Lanove/HotBerry/docs/pics/18.jpeg

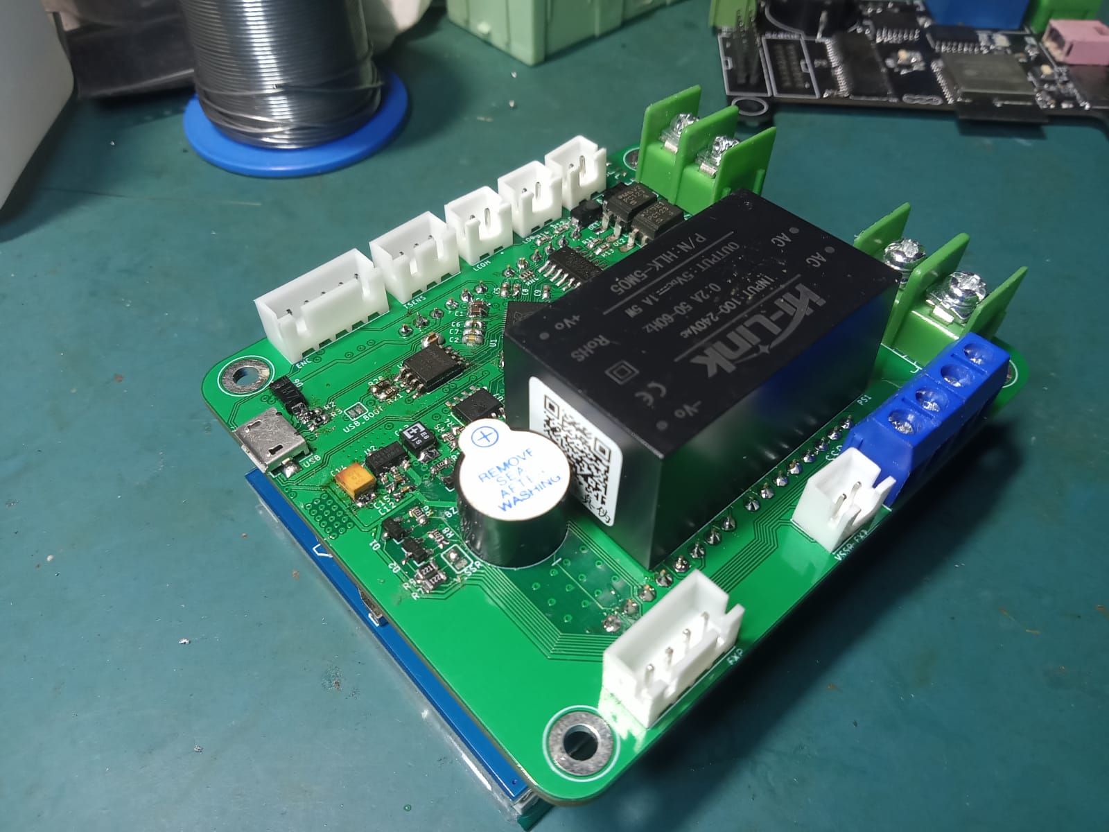
docs/pics/18.jpeg
