Lanove/HotBerry/docs/pics/13.jpeg

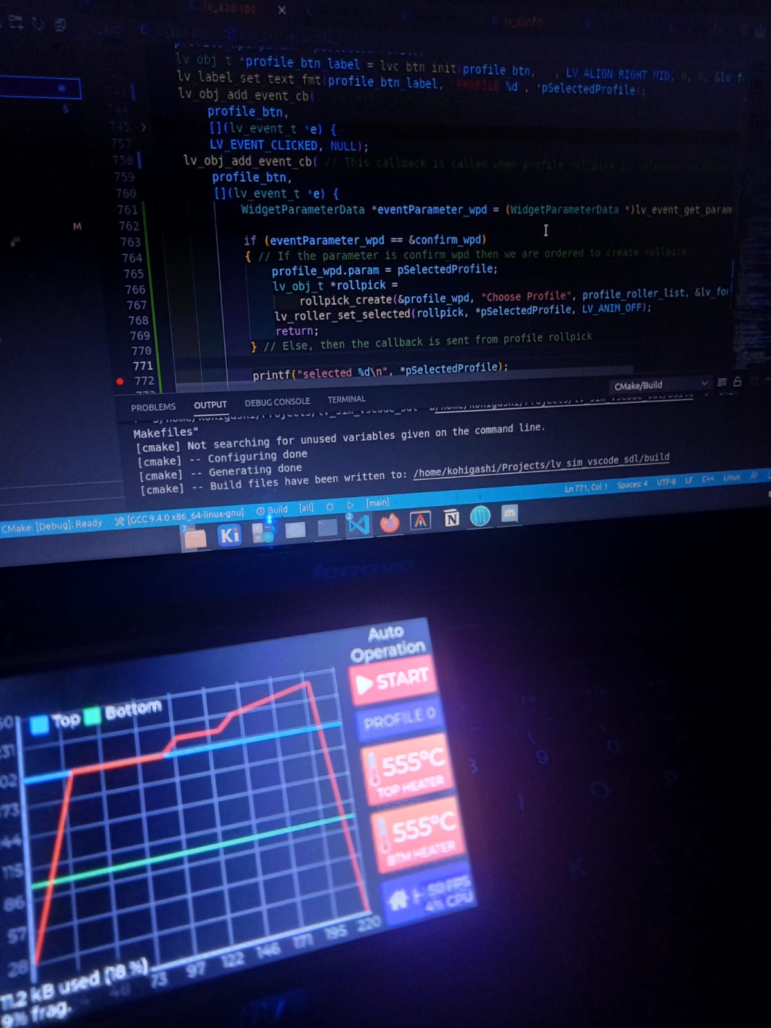
docs/pics/13.jpeg
