Lanove/HotBerry/docs/ILI9486 Data Format.pdf

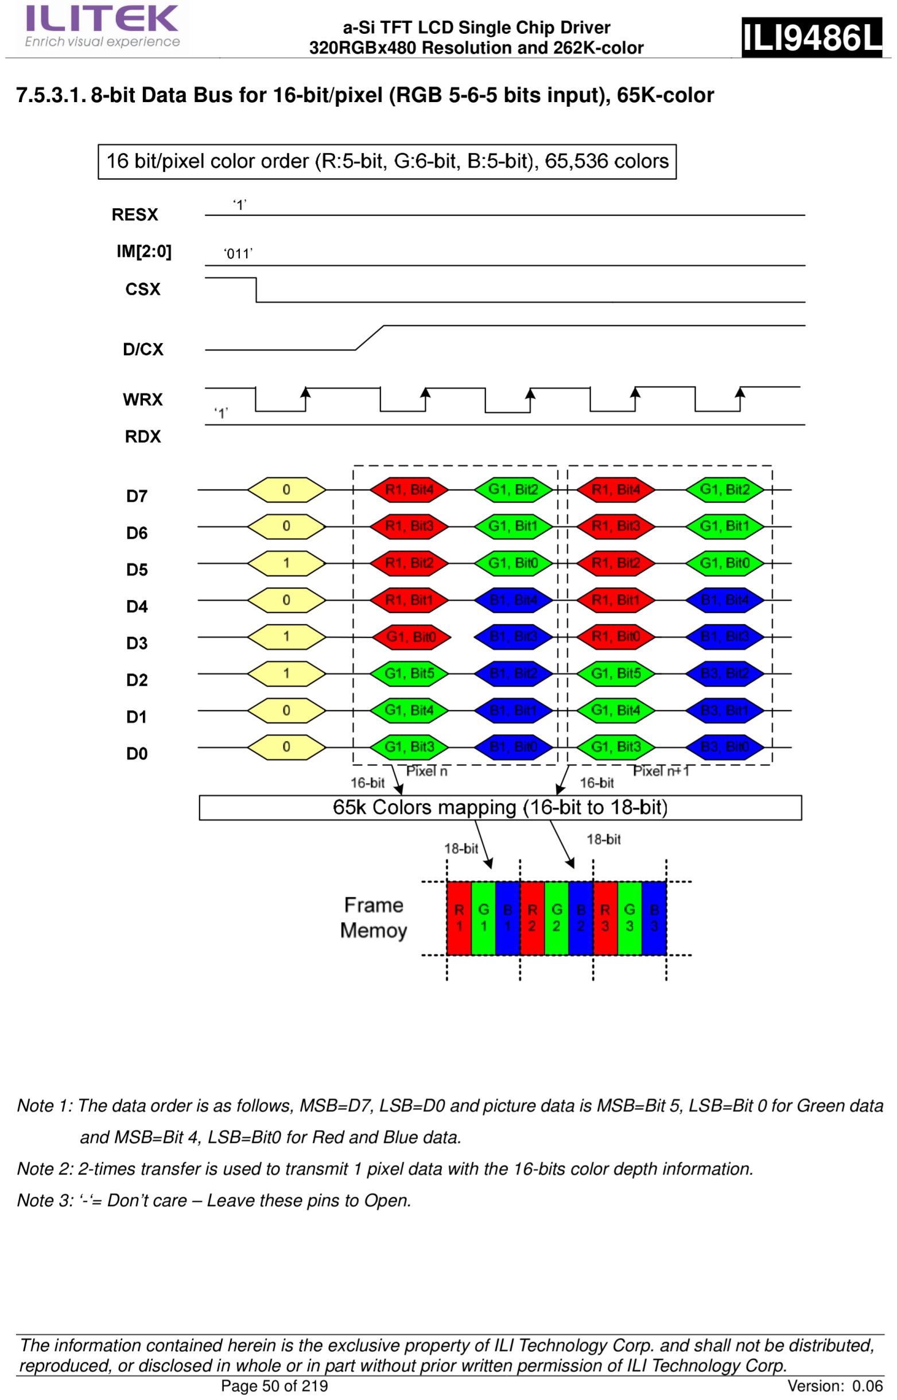
[picture p3: page 1]
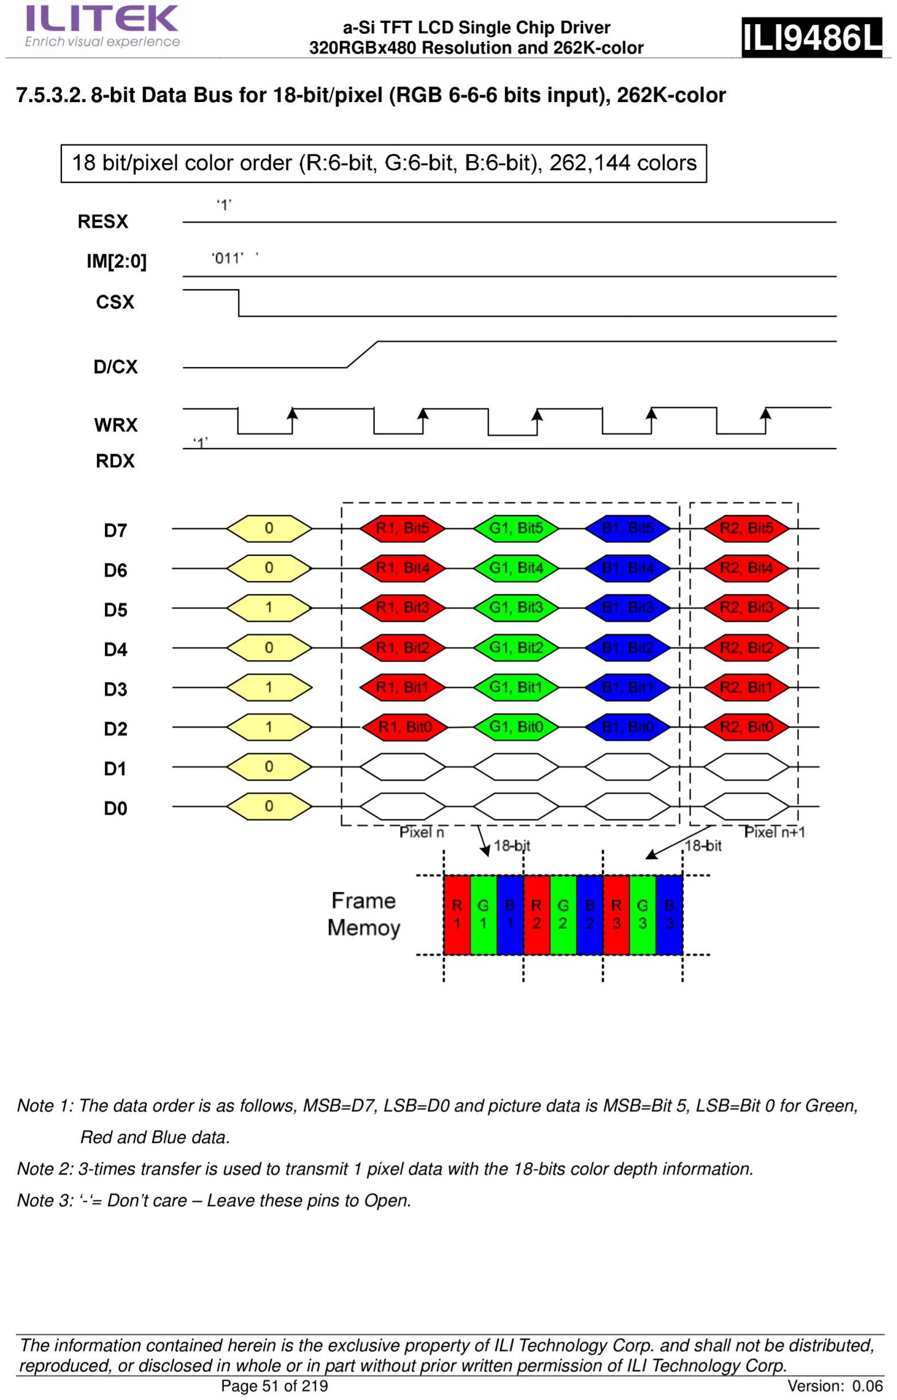
[picture p4: page 2]
