Lanove/HotBerry/docs/pics/4.jpeg

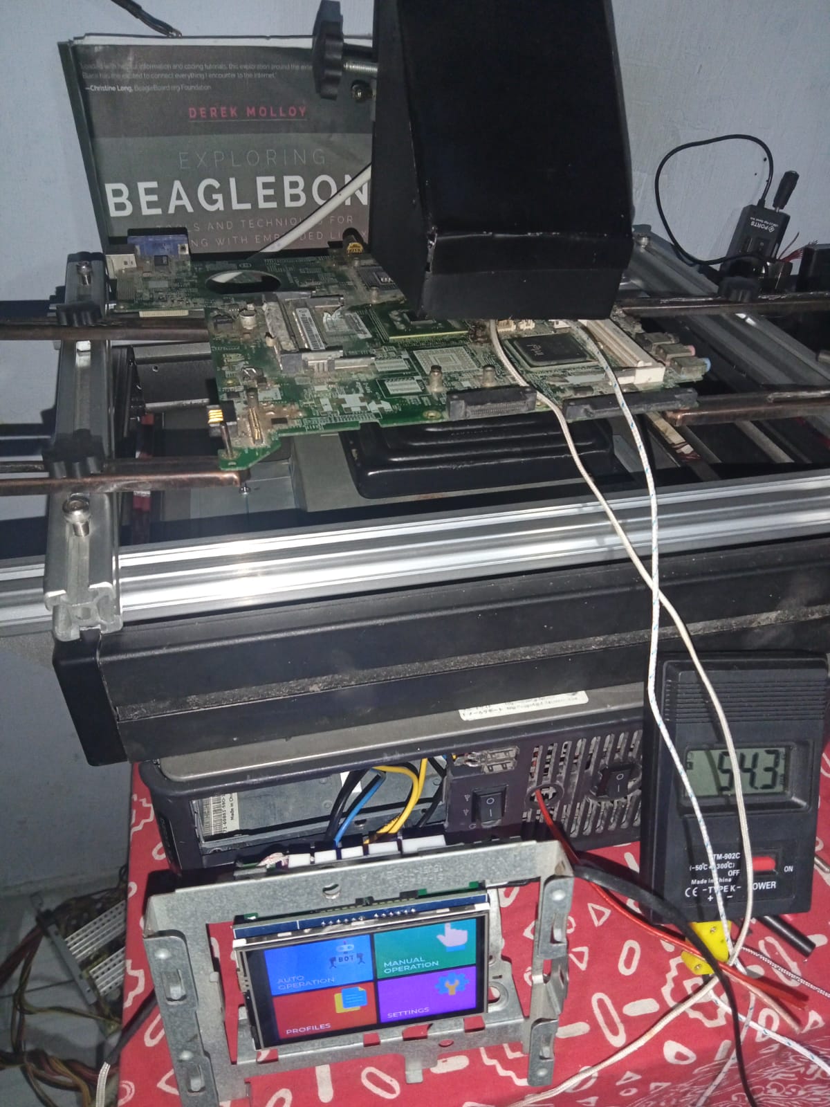
docs/pics/4.jpeg
