Lanove/HotBerry/docs/pics/5.jpeg

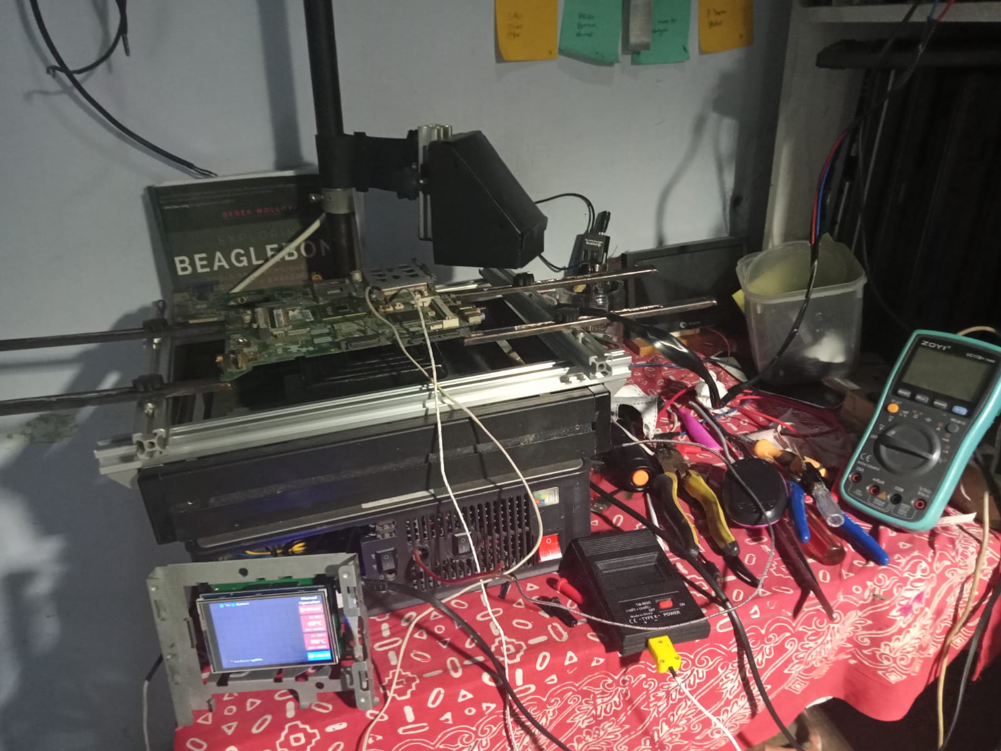
docs/pics/5.jpeg
