Lanove/HotBerry/docs/pics/6.jpeg

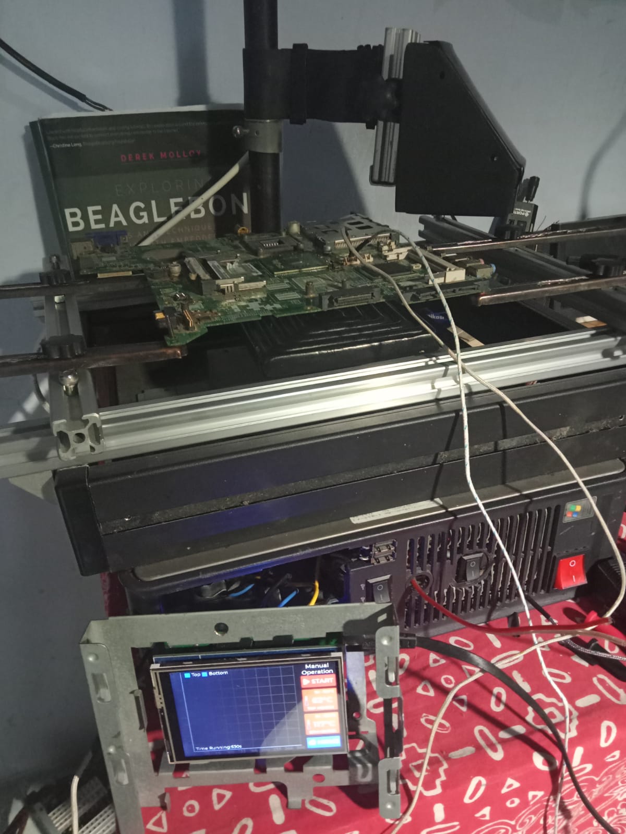
docs/pics/6.jpeg
