Lanove/HotBerry/docs/pics/7.jpeg

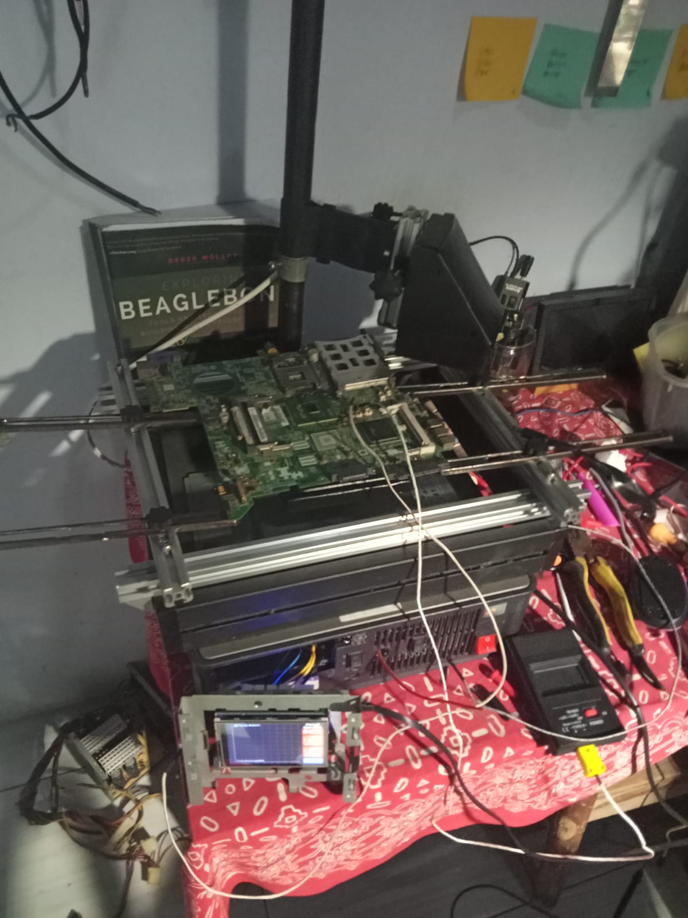
docs/pics/7.jpeg
