Lanove/HotBerry/docs/pics/8.jpeg

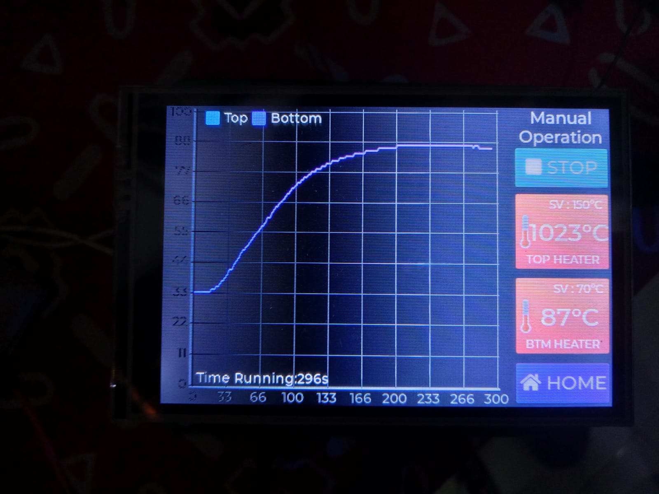
docs/pics/8.jpeg
