Lanove/HotBerry/docs/pics/9.jpeg

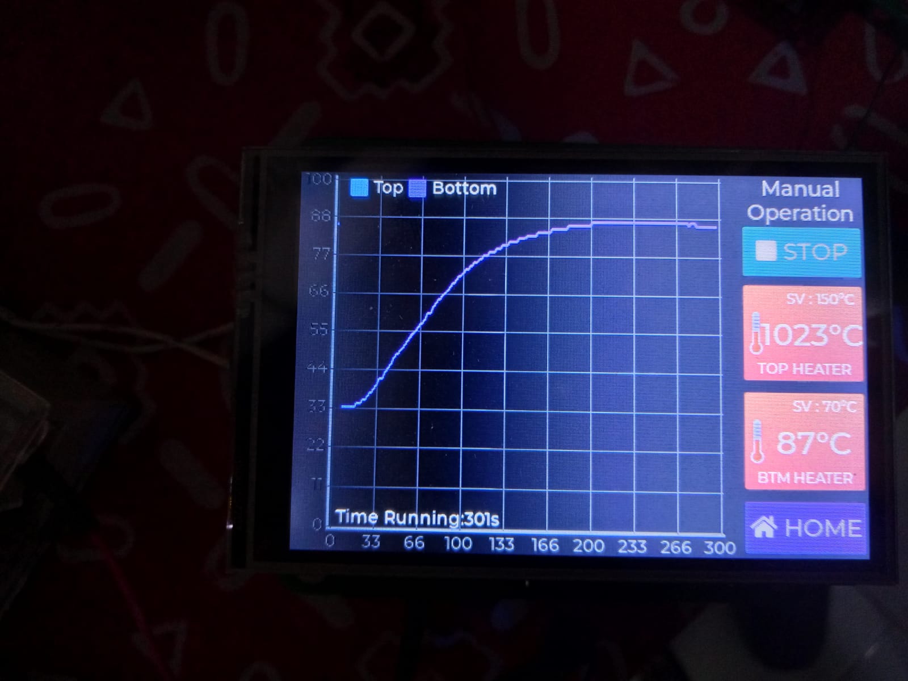
docs/pics/9.jpeg
