Lanove/HotBerry/docs/pics/10.jpeg

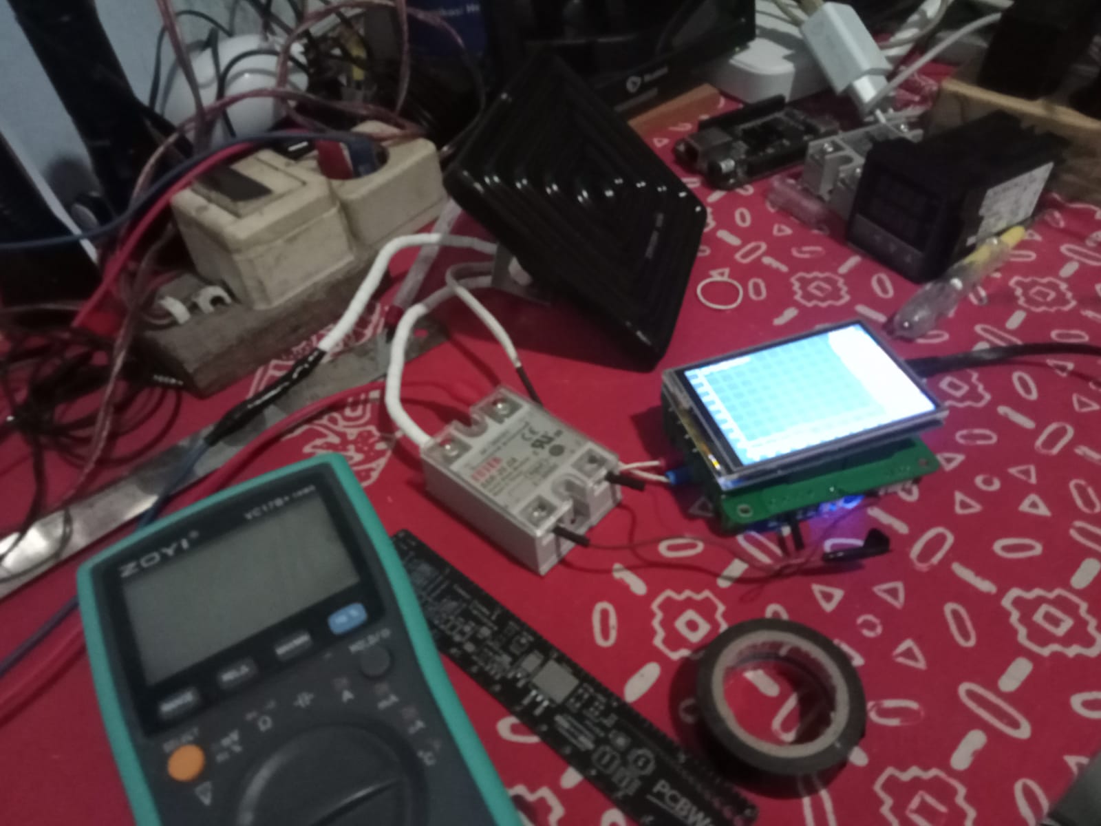
docs/pics/10.jpeg
