Lanove/HotBerry/docs/pics/11.jpeg

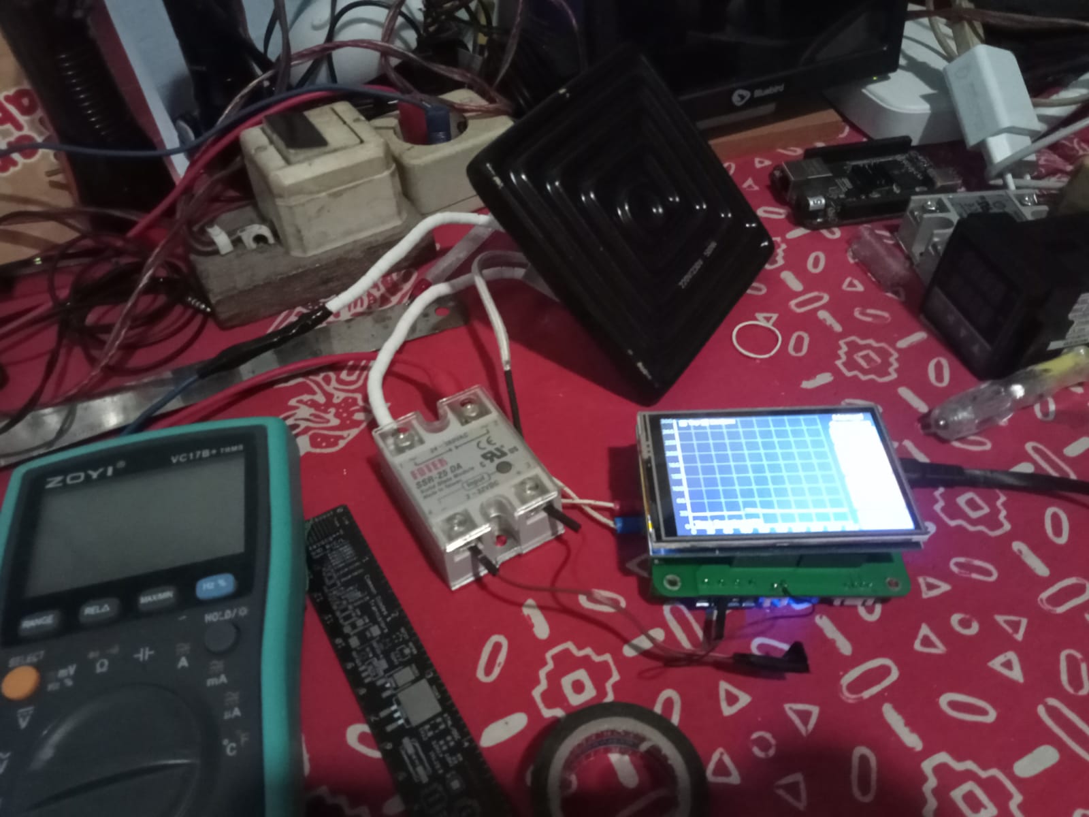
docs/pics/11.jpeg
