Lanove/HotBerry/docs/pics/12.jpeg

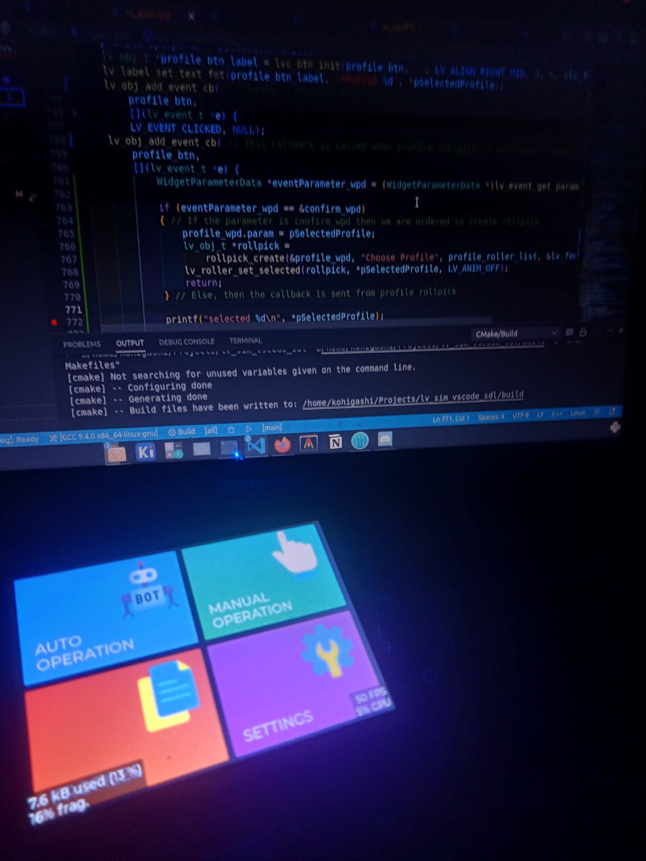
docs/pics/12.jpeg
