Lanove/HotBerry/docs/pics/14.jpeg

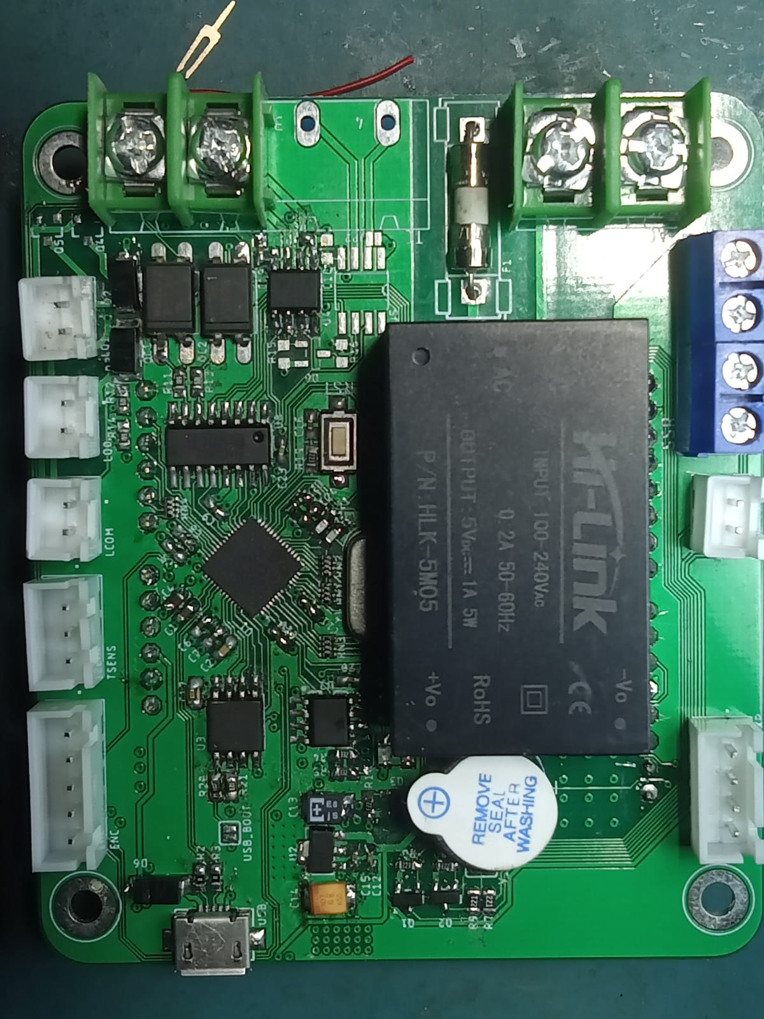
docs/pics/14.jpeg
