Lanove/HotBerry/docs/pics/15.jpeg

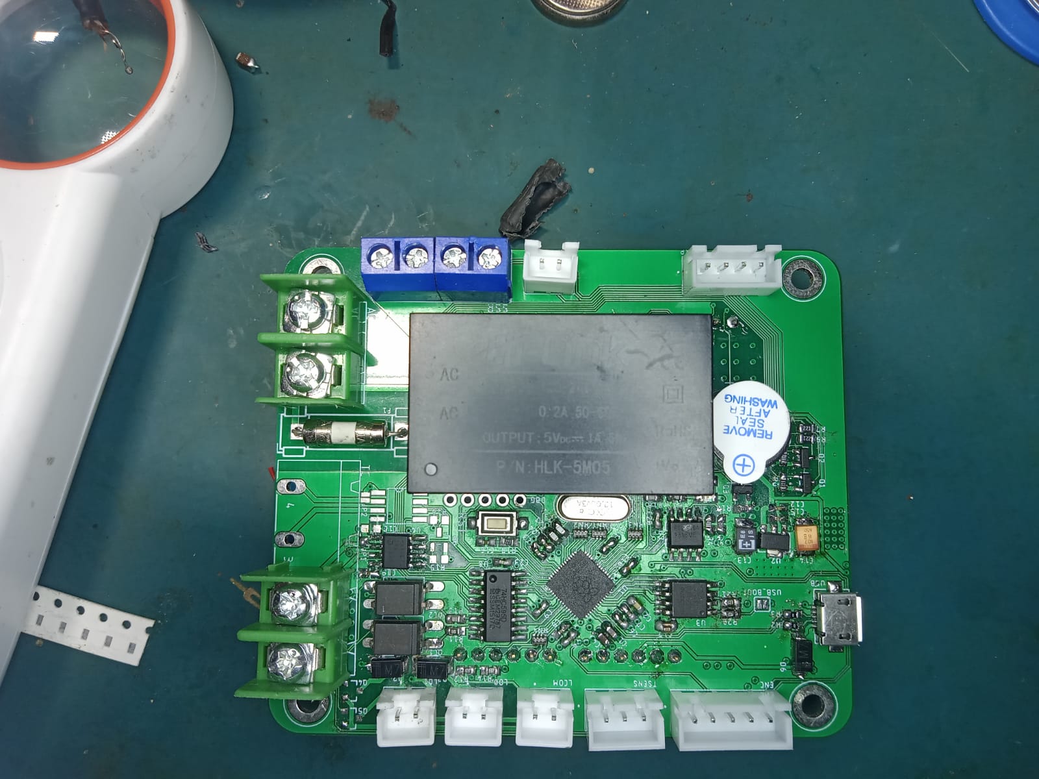
docs/pics/15.jpeg
