Lanove/HotBerry/docs/pics/16.jpeg

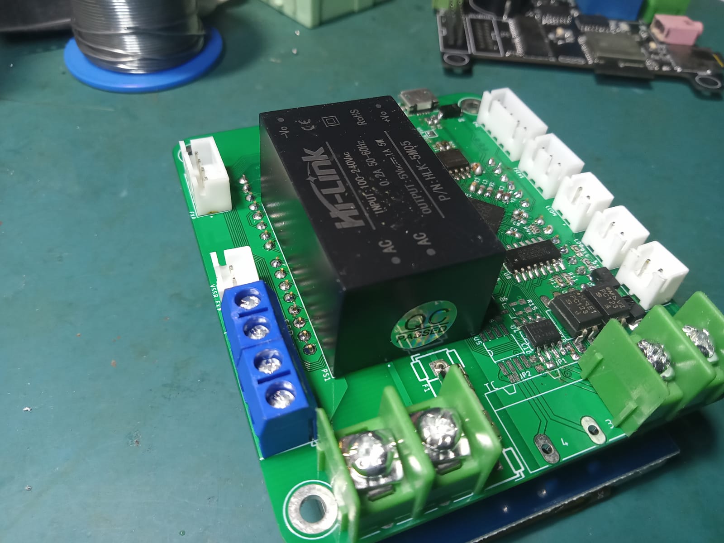
docs/pics/16.jpeg
