Lanove/HotBerry/docs/pics/19.jpeg

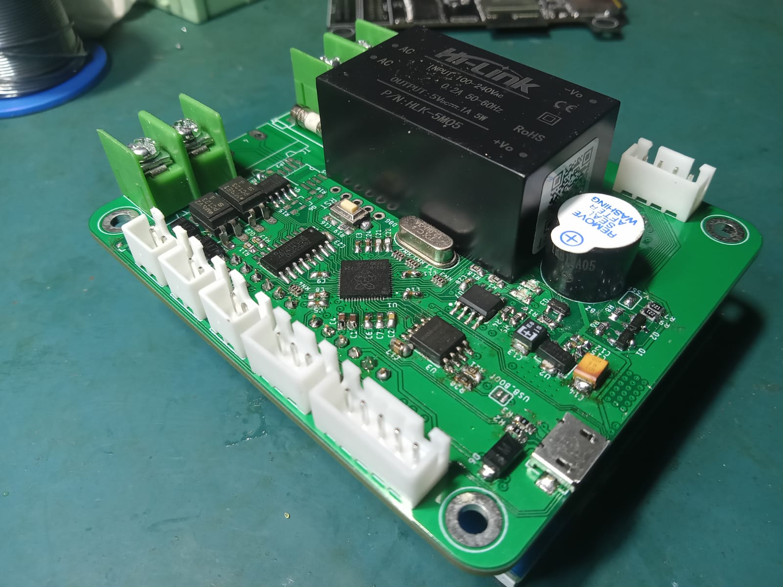
docs/pics/19.jpeg
