Lanove/HotBerry/docs/pics/20.jpeg

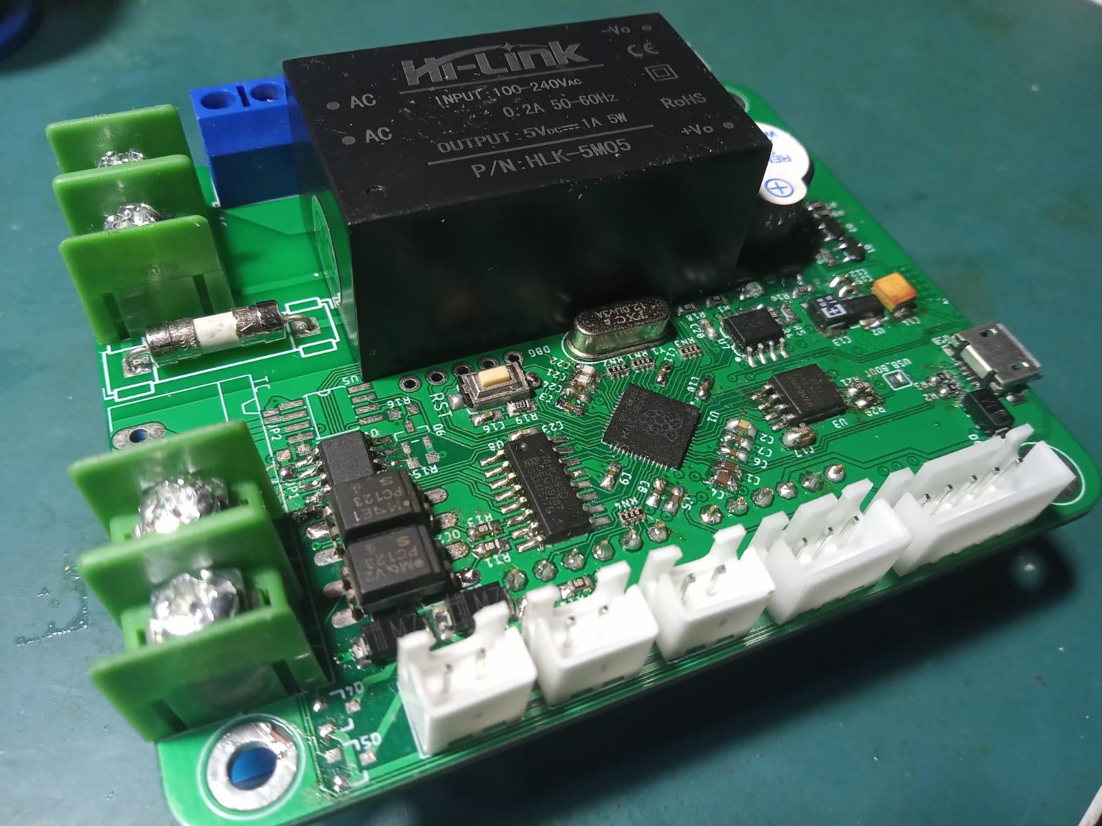
docs/pics/20.jpeg
