Lanove/HotBerry/docs/pics/21.jpeg

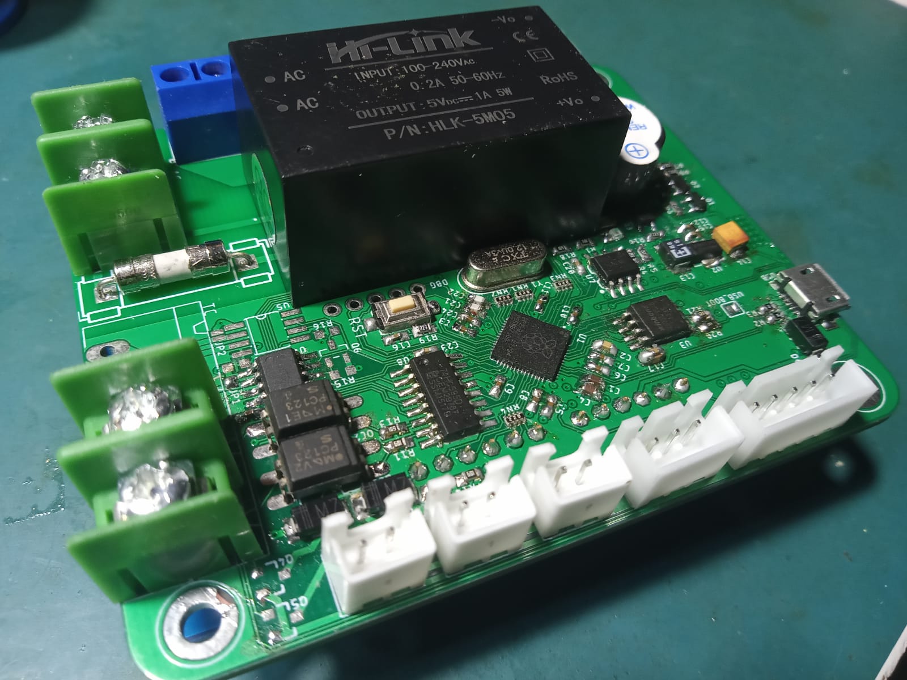
docs/pics/21.jpeg
