Lanove/HotBerry/docs/pics/22.jpeg

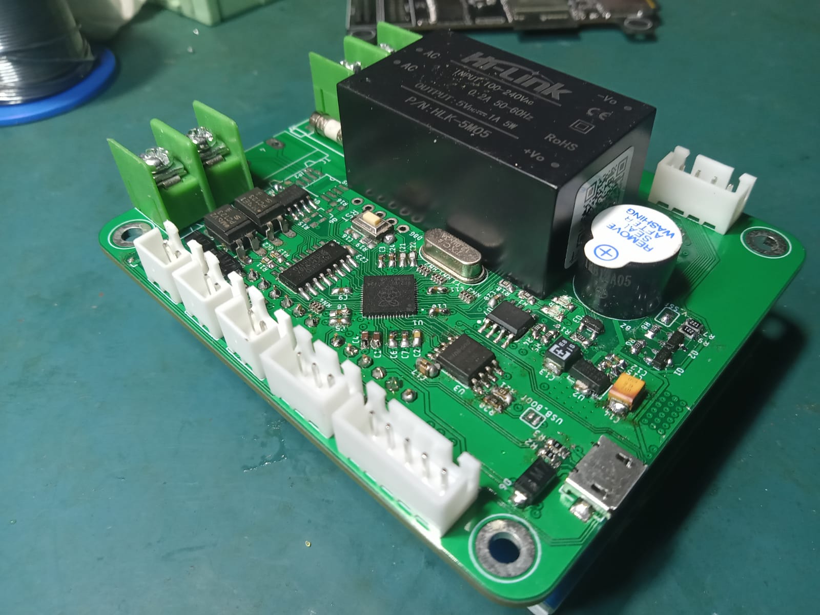
docs/pics/22.jpeg
