Lanove/HotBerry/docs/pics/23.jpeg

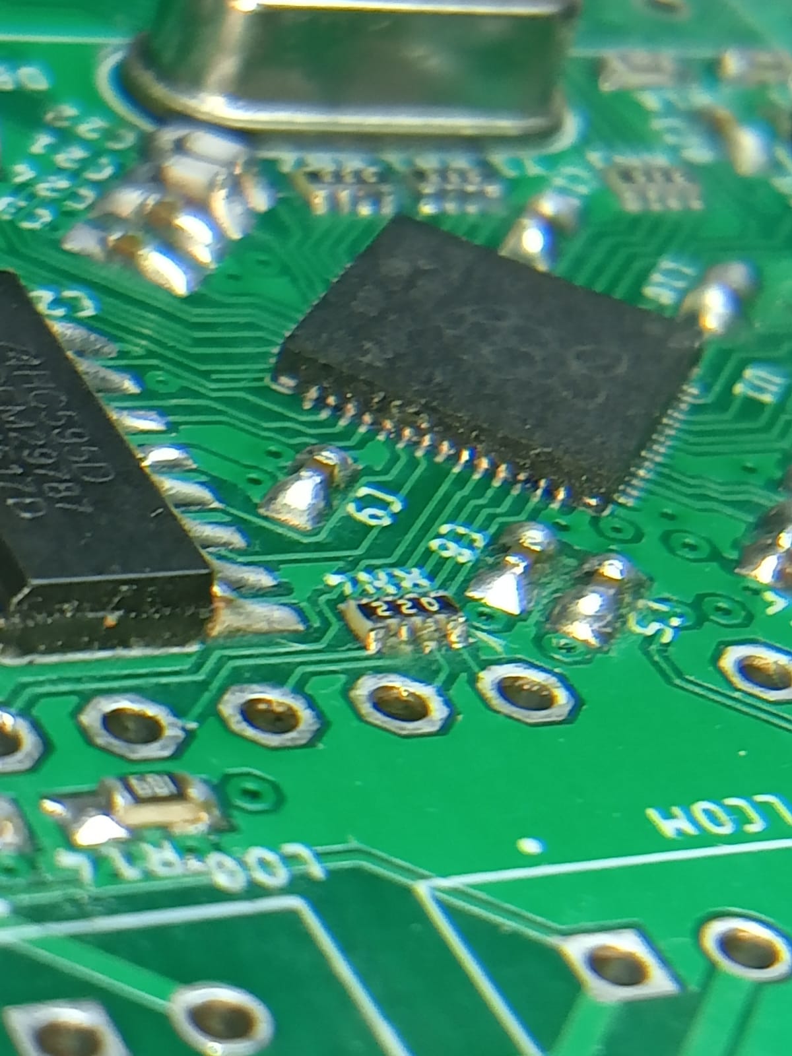
docs/pics/23.jpeg
