Lanove/HotBerry/docs/pics/24.jpeg

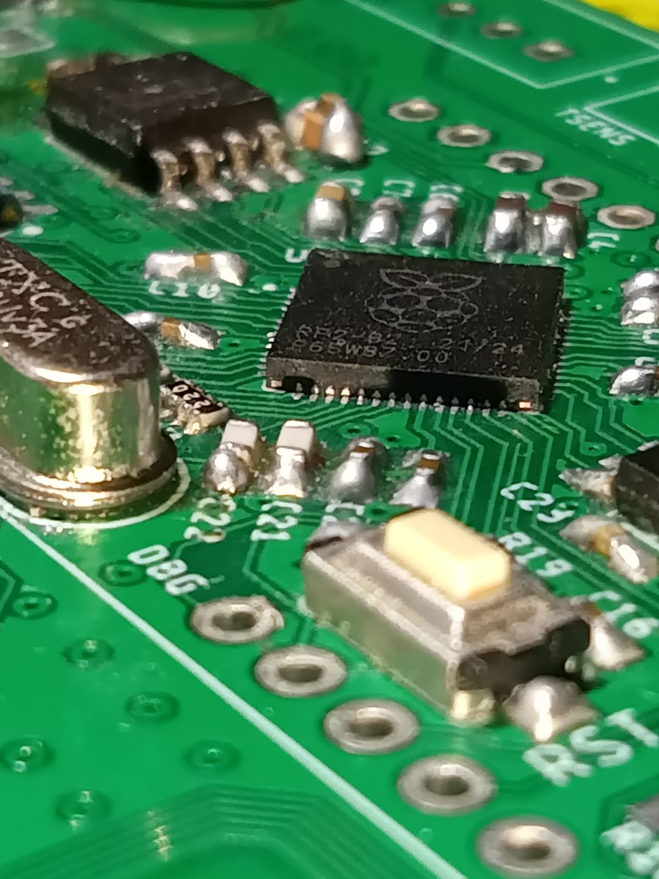
docs/pics/24.jpeg
