Lanove/HotBerry/docs/pics/25.jpeg

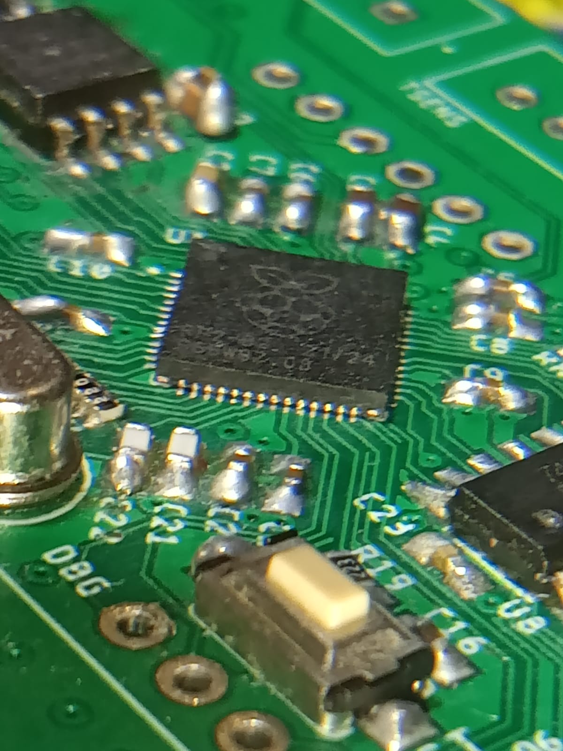
docs/pics/25.jpeg
