Lanove/HotBerry/docs/pics/26.jpeg

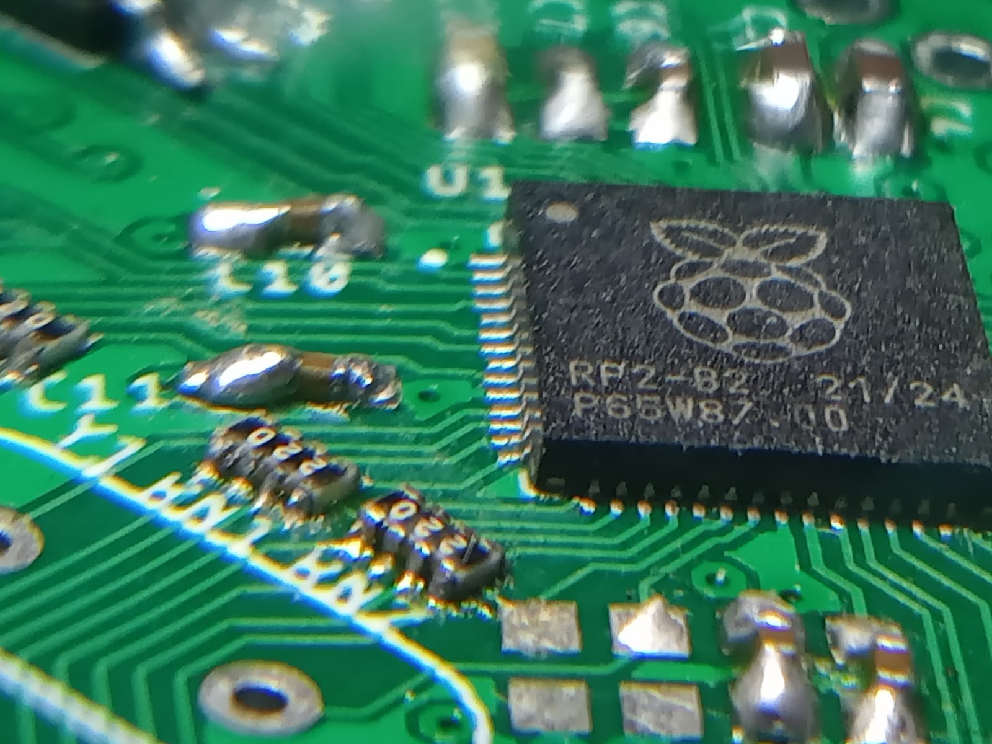
docs/pics/26.jpeg
