Lanove/HotBerry/docs/pics/123.jpeg

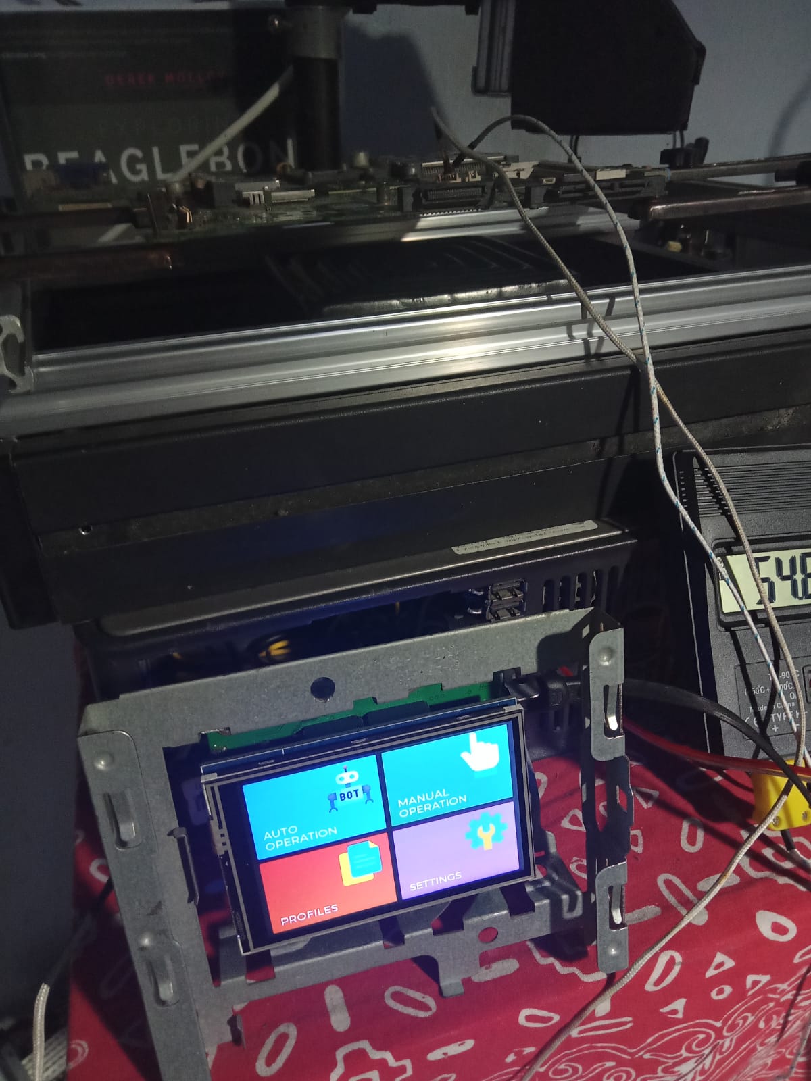
docs/pics/123.jpeg
