Lanove/HotBerry/docs/pics/index1.jpeg

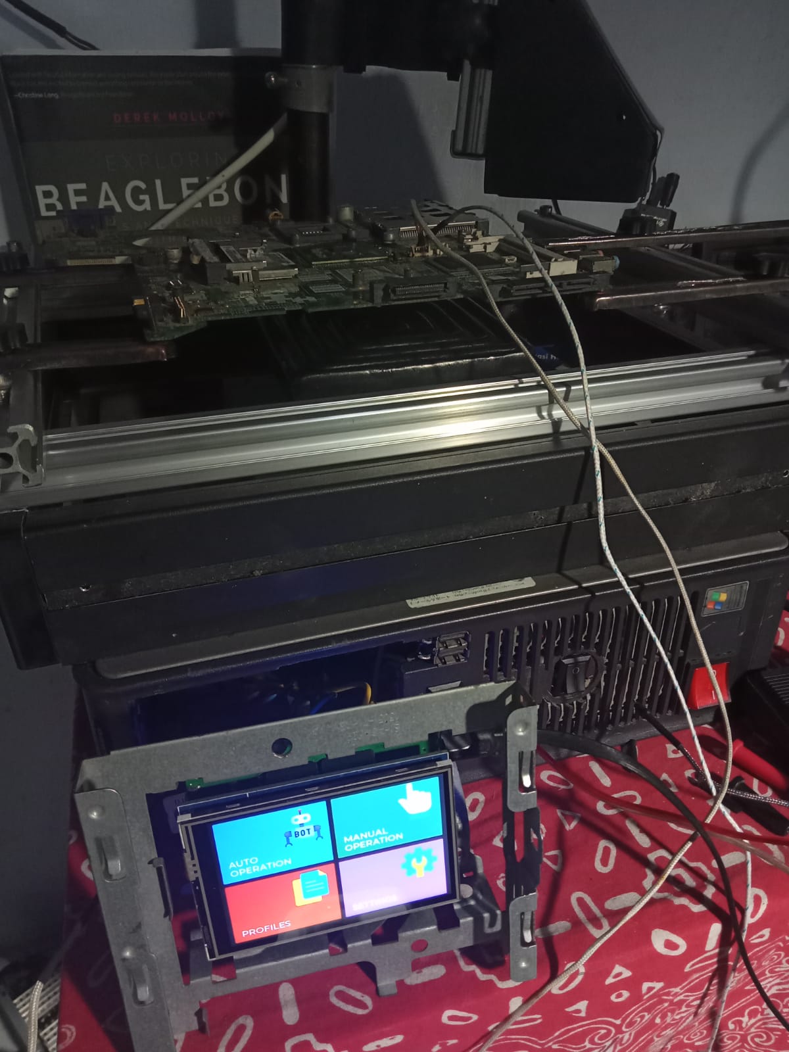
docs/pics/index1.jpeg
