Lanove/HotBerry/docs/pics/index.jpeg

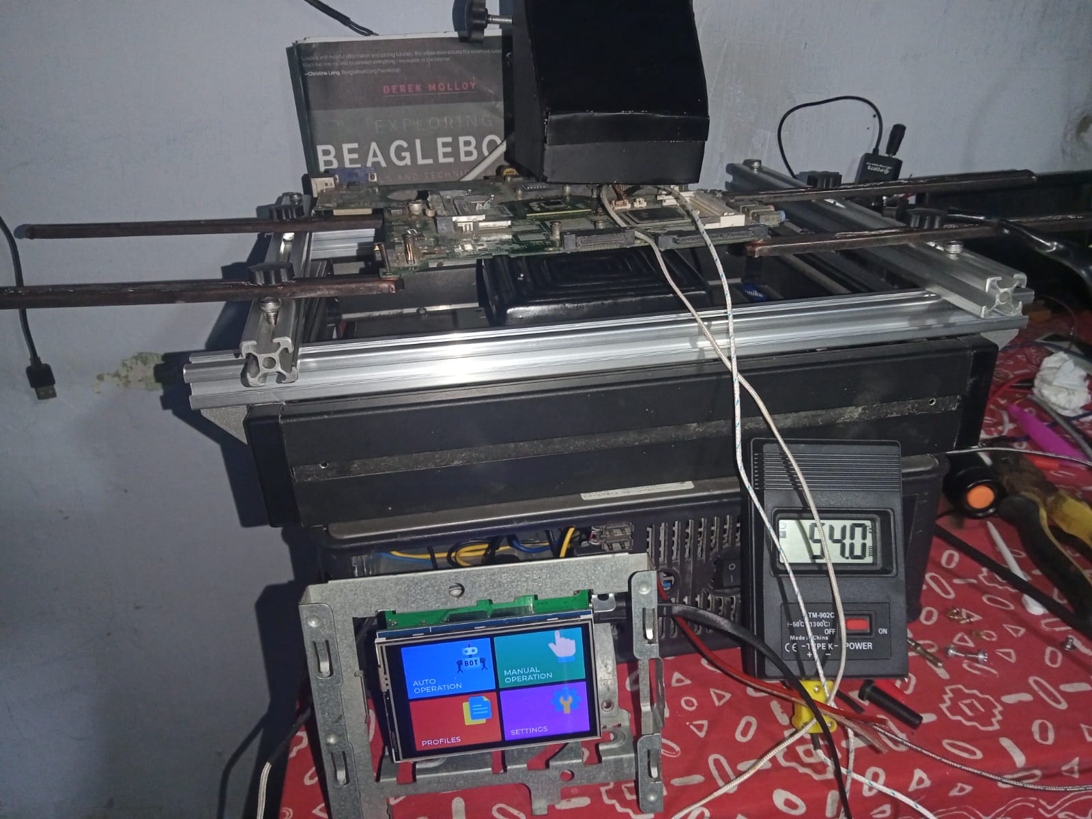
docs/pics/index.jpeg
