Lanove/HotBerry/docs/ILI9486 8-Bit Parallel Mode AC Characteristic.pdf

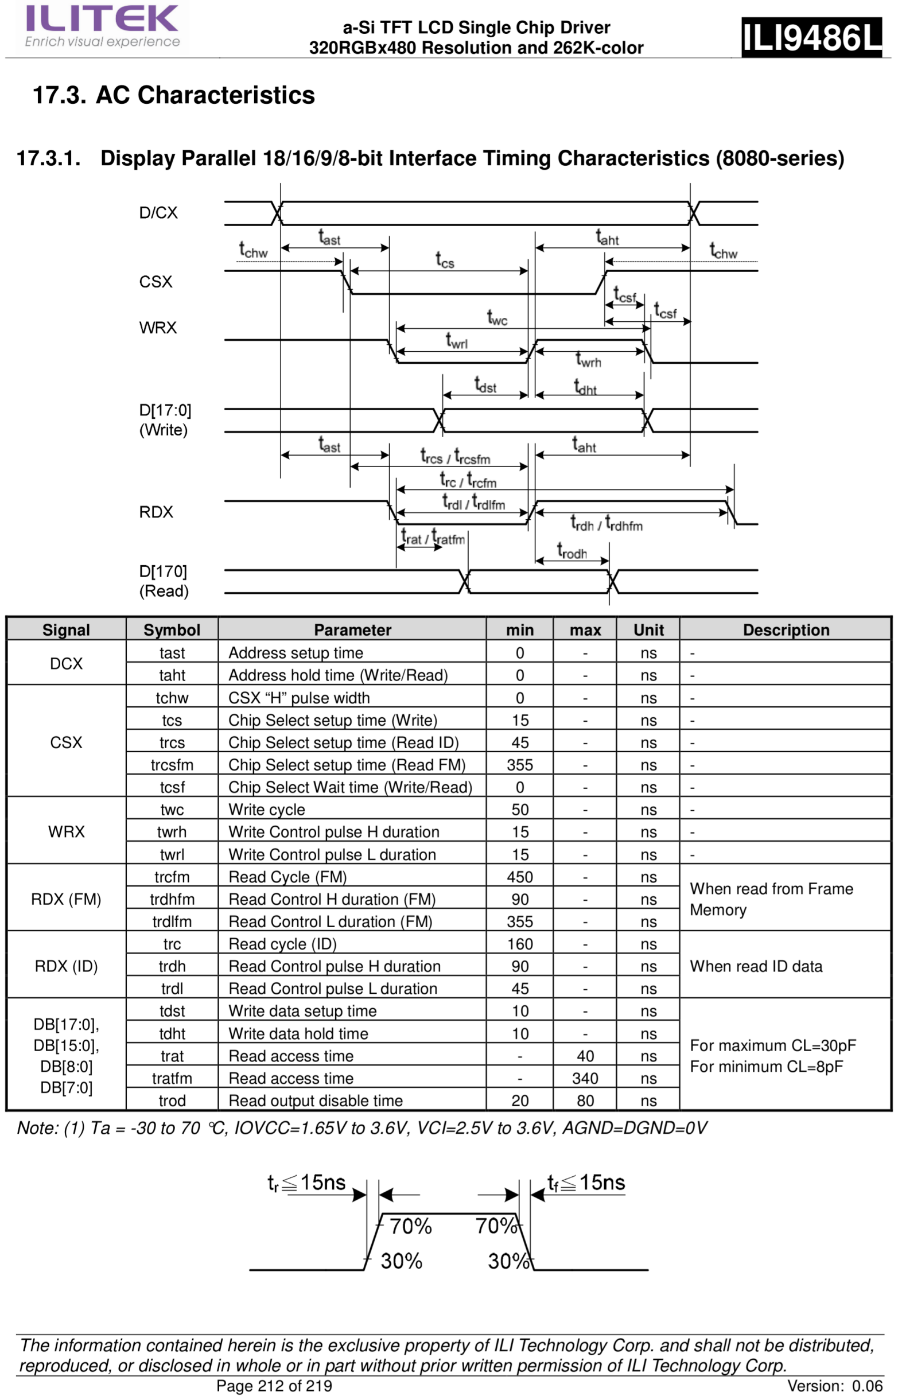
[picture p28: page 1]
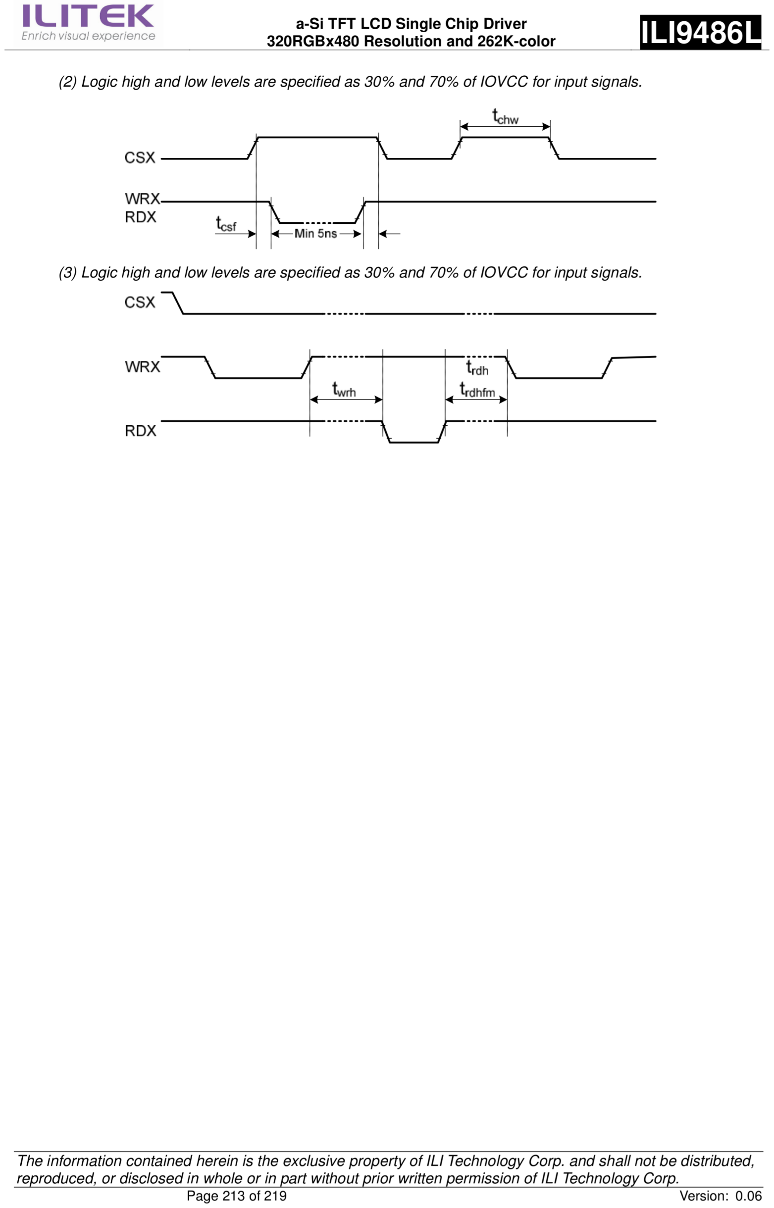
[picture p29: page 2]
