Lanove/HotBerry/hardware/2-layer.brd

## EAGLE design hardware/2-layer.brd (2022-06-09)

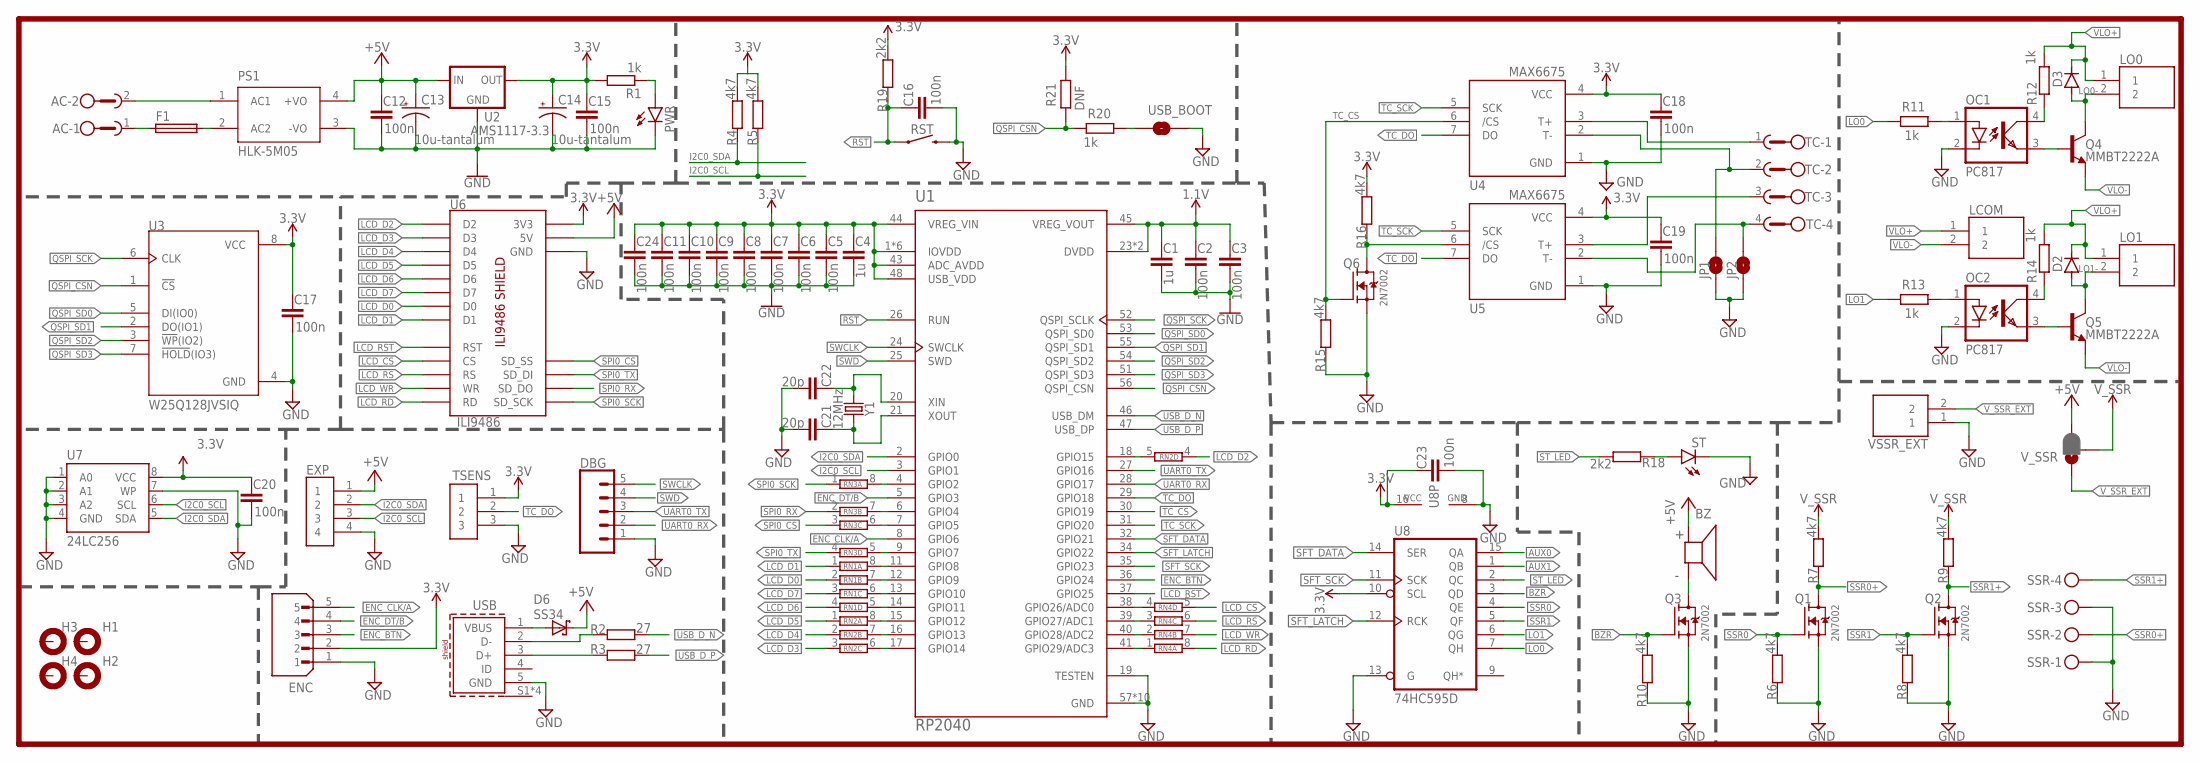
[picture p30: schematic 2-layer.sch]

Parts:
AC: GMSTBA2
BZ: AI-1223-TWT-12V-R; XDCR_AI-1223-TWT-12V-R
C1, C4: 1u; C0603K
C2, C3, C5, C6, C7, C8, C9, C10, C11, C12, C15, C16, C17, C18, C19, C20, C23, C24: 100n; C0603K
C13, C14: 10u-tantalum; CT3528
C21, C22: 20p; C0603K
D2, D3: DIODE-DO-214AC; DO-214AC
D6: SS34; DO214
DBG: CONN_05NO_SILK; 1X05_NO_SILK
ENC: B5B-XH-A(LF)(SN); JST_B5B-XH-A(LF)(SN)
EXP: JST-XH-4P; JST_B4B-XH-A(LF)(SN)
F1: FUSEBLANK_5X20MM; FUSE_HOLDER_5X20MM
H1, H2, H3, H4: MOUNT-PAD-ROUND3.2; 3,2-PAD
JP1, JP2: JUMPER-SMT_2_NO_NO-SILK; SMT-JUMPER_2_NO_NO-SILK
LCOM: B2B-XH-A(LF)(SN); JST_B2B-XH-A(LF)(SN)
LO0, LO1: B2B-XH-A(LF)(SN); JST_B2B-XH-A(LF)(SN)
OC1, OC2: PC817; DIL04
PS1: HLK-5M05; CONV_HLK-5M05
PWR: LEDCHIP-LED0805; CHIP-LED0805
Q1, Q2, Q3, Q6: 2N7002; SOT95P240X111-3N
Q4, Q5: MMBT2222A; SOT23-3
R1, R11, R12, R13, R14, R20: 1k; R0603
R2, R3: 27; R0603
R4, R5, R6, R7, R8, R9, R10, R15, R16: 4k7; R0603
R18, R19: 2k2; R0603
R21: DNF; R0603
RN1, RN2, RN3, RN4: 4R-N0402ARV341; 4X0402ARV341
RST: MOMENTARY-SWITCH-SPST-SMD-6.0X3.5MM; TACTILE_SWITCH_SMD_6.0X3.5MM
SSR: MKDSN1,5/4-5,08
ST: LEDCHIP-LED0805; CHIP-LED0805
TC: GMSTBA4
TSENS: B3B-XH-A(LF)(SN); JST_B3B-XH-A(LF)(SN)
U1: RP2040; QFN40P700X700X90-57N
U2: AMS1117-3.3; SOT89R
U3: W25Q128JVSIQ; SOIC127P790X216-8N
U4, U5: MAX6675; SO08
U6: ILI9486; ILI9486-SHIELD
U7: 24LC256; SO08
U8: 74HC595D; SO16
USB: 629105136821
USB_BOOT: JUMPER-SMT_2_NO_SILK; SMT-JUMPER_2_NO_SILK
VSSR_EXT: B2B-XH-A(LF)(SN); JST_B2B-XH-A(LF)(SN)
V_SSR: JUMPER-SMT_3_1-NC_PASTE_SILK; SMT-JUMPER_3_1-NC_PASTE_SILK
Y1: 12MHz; HC49US

Connections:
1.1V: C1.1, C2.1, C3.1, U1.23 (DVDD), U1.45 (VREG_VOUT), U1.50 (DVDD)
3.3V: C4.1, C5.1, C6.1, C7.1, C8.1, C9.1, C10.1, C11.1, C14.+, C15.1, C17.1, C18.1, C19.1, C20.1, C23.1, C24.1, ENC.2, R1.2, R4.1, R5.1, R16.1, R19.1, R21.2, TSENS.1, U1.1 (IOVDD), U1.10 (IOVDD), U1.22 (IOVDD), U1.33 (IOVDD), U1.42 (IOVDD), U1.43 (ADC_AVDD), U1.44 (VREG_VIN), U1.48 (USB_VDD), U1.49 (IOVDD), U2.3 (OUT), U2.4 (OUT), U3.8 (VCC), U4.4 (VCC), U5.4 (VCC), U6.3V3, U7.8 (VCC), U8.10 (SCL), U8.16 (VCC)
+5V: BZ.P (+), C12.1, C13.+, D6.C, EXP.1, PS1.4 (+VO), U2.1 (IN), U6.5V, V_SSR.3
AUX0: U8.15 (QA)
AUX1: U8.1 (QB)
BZR: Q3.1 (G), R10.1, U8.3 (QD)
ENC_BTN: ENC.3, U1.36 (GPIO24)
ENC_CLK/A: ENC.5, U1.8 (GPIO6)
ENC_DT/B: ENC.4, U1.5 (GPIO3)
GND: C1.2, C2.2, C3.2, C4.2, C5.2, C6.2, C7.2, C8.2, C9.2, C10.2, C11.2, C12.2, C13.-, C14.-, C15.2, C16.2, C17.2, C18.2, C19.2, C20.2, C21.2, C22.2, C23.2, C24.2, DBG.1, ENC.1, EXP.4, JP1.1, JP2.1, OC1.2 (C), OC2.2 (C), PS1.3 (-VO), PWR.C, Q1.2 (S), Q2.2 (S), Q3.2 (S), Q6.2 (S), R6.2, R8.2, R10.2, R15.2, RST.2, SSR.1, SSR.3, ST.C, TSENS.3, U1.19 (TESTEN), U1.57 (GND), U1.P$1 (GND), U1.P$2 (GND), U1.P$3 (GND), U1.P$4 (GND), U1.P$5 (GND), U1.P$6 (GND), U1.P$7 (GND), U1.P$8 (GND), U1.P$9 (GND), U2.2 (GND), U3.4 (GND), U4.1 (GND), U5.1 (GND), U6.GND, U6.GND1 (GND), U6.GND2 (GND), U7.1 (A0), U7.2 (A1), U7.3 (A2), U7.4 (GND), U7.7 (WP), U8.8 (GND), U8.13 (G), USB.5 (GND), USB_BOOT.2, VSSR_EXT.1
I2C0_SCL: EXP.3, R5.2, U1.3 (GPIO1), U7.6 (SCL)
I2C0_SDA: EXP.2, R4.2, U1.2 (GPIO0), U7.5 (SDA)
LCD_CS: RN4.5 (2), U6.LCD_CS (CS)
LCD_D0: RN1.2 (1), U6.LCD_D0 (D0)
LCD_D1: RN1.1, U6.LCD_D1 (D1)
LCD_D2: RN2.4 (1), U6.LCD_D2 (D2)
LCD_D3: RN2.3 (1), U6.LCD_D3 (D3)
LCD_D4: RN2.2 (1), U6.LCD_D4 (D4)
LCD_D5: RN2.1, U6.LCD_D5 (D5)
LCD_D6: RN1.4 (1), U6.LCD_D6 (D6)
LCD_D7: RN1.3 (1), U6.LCD_D7 (D7)
LCD_RD: RN4.8 (2), U6.LCD_RD (RD)
LCD_RS: RN4.6 (2), U6.LCD_RS (RS)
LCD_RST: U1.37 (GPIO25), U6.LCD_RST (RST)
LCD_WR: RN4.7 (2), U6.LCD_WR (WR)
LO0: R11.1, U8.7 (QH)
LO0-: D3.A, LO0.2, Q4.3 (C)
LO1: R13.1, U8.6 (QG)
LO1-: D2.A, LO1.2, Q5.3 (C)
unnamed: AC.1, F1.1
unnamed: F1.2, PS1.2 (AC2)
unnamed: AC.2, PS1.1 (AC1)
unnamed: PWR.A, R1.1
unnamed: BZ.N (-), Q3.3 (D)
unnamed: R3.2, USB.3 (D+)
unnamed: R2.2, USB.2 (D-)
unnamed: OC1.1 (A), R11.2
unnamed: OC1.4 (COL), R12.2
unnamed: OC1.3 (EMIT), Q4.1 (B)
unnamed: OC2.1 (A), R13.2
unnamed: OC2.4 (COL), R14.2
unnamed: OC2.3 (EMIT), Q5.1 (B)
unnamed: Q6.3 (D), R16.2, U5.6 (/CS)
unnamed: RN1.6 (2), U1.13 (GPIO10)
unnamed: R20.2, USB_BOOT.1
unnamed: RN1.7 (2), U1.12 (GPIO9)
unnamed: R18.2, ST.A
unnamed: RN1.8 (2), U1.11 (GPIO8)
unnamed: RN1.5 (2), U1.14 (GPIO11)
unnamed: RN2.8 (2), U1.15 (GPIO12)
unnamed: RN2.7 (2), U1.16 (GPIO13)
unnamed: RN2.6 (2), U1.17 (GPIO14)
unnamed: D6.A, USB.1 (VBUS)
unnamed: RN2.5 (2), U1.18 (GPIO15)
unnamed: RN3.8 (2), U1.4 (GPIO2)
unnamed: RN3.7 (2), U1.6 (GPIO4)
unnamed: RN3.6 (2), U1.7 (GPIO5)
unnamed: RN3.5 (2), U1.9 (GPIO7)
unnamed: RN4.4 (1), U1.38 (GPIO26/ADC0)
unnamed: RN4.3 (1), U1.39 (GPIO27/ADC1)
unnamed: RN4.2 (1), U1.40 (GPIO28/ADC2)
unnamed: RN4.1, U1.41 (GPIO29/ADC3)
unnamed: JP2.2, TC.4, U5.2 (T-)
unnamed: JP1.2, TC.2, U4.2 (T-)
QSPI_CSN: R20.1, R21.1, U1.56 (QSPI_CSN), U3.1 (!CS)
QSPI_SCK: U1.52 (QSPI_SCLK), U3.6 (CLK)
QSPI_SD0: U1.53 (QSPI_SD0), U3.5 (DI(IO0))
QSPI_SD1: U1.55 (QSPI_SD1), U3.2 (DO(IO1))
QSPI_SD2: U1.54 (QSPI_SD2), U3.3 (!WP!(IO2))
QSPI_SD3: U1.51 (QSPI_SD3), U3.7 (!HOLD!(IO3))
RST: C16.1, R19.2, RST.1, U1.26 (RUN)
SFT_DATA: U1.32 (GPIO21), U8.14 (SER)
SFT_LATCH: U1.34 (GPIO22), U8.12 (RCK)
SFT_SCK: U1.35 (GPIO23), U8.11 (SCK)
SPI0_CS: RN3.3 (1), U6.SD_SS
SPI0_RX: RN3.2 (1), U6.SD_DO
SPI0_SCK: RN3.1, U6.SD_SCK
SPI0_TX: RN3.4 (1), U6.SD_DI
SSR0: Q1.1 (G), R6.1, U8.4 (QE)
SSR0+: Q1.3 (D), R7.2, SSR.2
SSR1: Q2.1 (G), R8.1, U8.5 (QF)
SSR1+: Q2.3 (D), R9.2, SSR.4
ST_LED: R18.1, U8.2 (QC)
SWCLK: DBG.5, U1.24 (SWCLK)
SWD: DBG.4, U1.25 (SWD)
TC+0: TC.1, U4.3 (T+)
TC+1: TC.3, U5.3 (T+)
TC_CS: Q6.1 (G), R15.1, U1.30 (GPIO19), U4.6 (/CS)
TC_DO: TSENS.2, U1.29 (GPIO18), U4.7 (DO), U5.7 (DO)
TC_SCK: U1.31 (GPIO20), U4.5 (SCK), U5.5 (SCK)
UART0_RX: DBG.2, U1.28 (GPIO17)
UART0_TX: DBG.3, U1.27 (GPIO16)
USB_D_N: R2.1, U1.46 (USB_DM)
USB_D_P: R3.1, U1.47 (USB_DP)
VLO+: D2.C, D3.C, LCOM.1, LO0.1, LO1.1, R12.1, R14.1
VLO-: LCOM.2, Q4.2 (E), Q5.2 (E)
V_SSR: R7.1, R9.1, V_SSR.2
V_SSR_EXT: VSSR_EXT.2, V_SSR.1
XIN: C22.1, U1.20 (XIN), Y1.2
XOUT: C21.1, U1.21 (XOUT), Y1.1

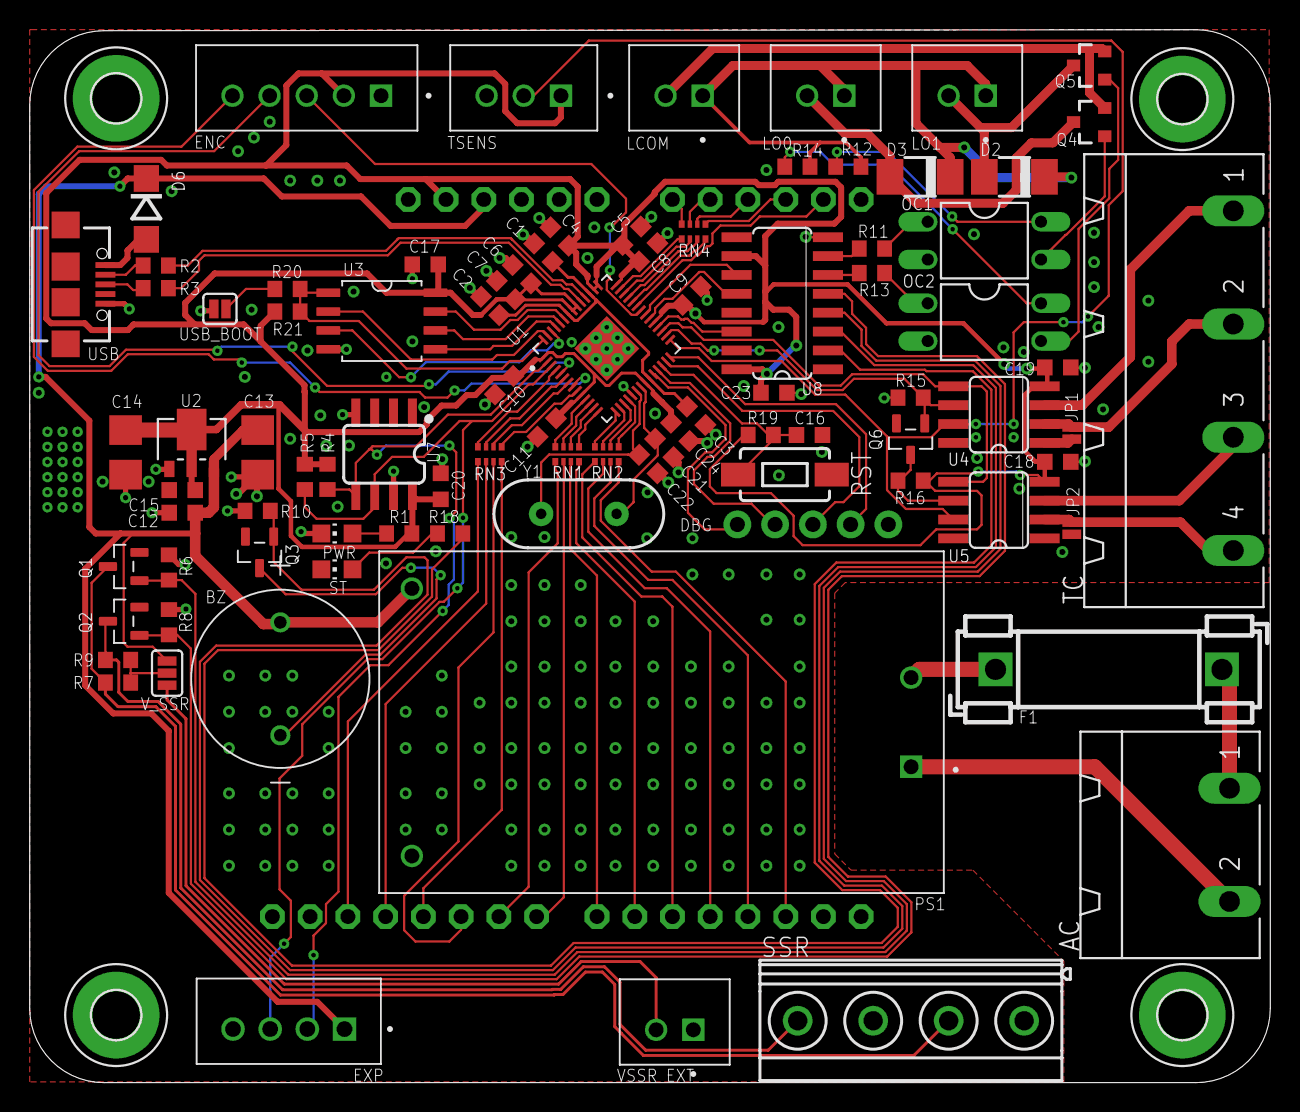
[picture p31: board 2-layer.brd from above]

Board: 2 copper layers, 83.5 x 70.9 mm, 94 parts (1 on the bottom side), 98 nets.
