Lanove/HotBerry/(commit log)

2022-06-09 Add hardware files
    [2-layer.brd, 2-layer.sch, 4-layer.brd, 4-layer.sch]
2022-06-10 TFT Drivers in progress
2022-06-11 TFT Driver works, unoptimized uncleaned
2022-06-12 Added touch api to tft library Added hotberry board settings to repo
2022-06-14 Added PIO (glitchy display on LVGL)
    [main.cpp]
2022-06-14 Fixed display glitch by removing 22 ohm series resistor on TFT lines
    [main.cpp]
2022-06-14 Added DMA colors transfer
2022-06-14 Added DMA with IRQ
2022-06-14 Changed some init command for better display color and frame rate
2022-06-15 Partially refactored, DMA is broken
    [main.cpp]
2022-06-15 Fixed DMA setRotation now uses PIO operation (can be called after init)
    [main.cpp]
2022-06-16 Added MAX6675 driver Added FreeRTOS port (WIP)
2022-07-04 Added EEPROM load to lv_app BUG : Choosing profile on profile screen causes crash
    [globals.h, main.cpp]
2022-07-04 Fixed profile button crash
2022-07-04 Fixed rollpick profile select crash
    [main.cpp]
2022-07-05 Added EEPROM interface to profile and PID memory
2022-07-08 pid failed attempt
2022-07-11 PID brett
2022-07-13 Added SSR PWM
2022-07-13 Migrated to FreeRTOS Using Phil's PID controller
2022-07-21 Changed PID constants datatype to double Implemented SSR PWM, the PWM value is sent via queue Implemented PID
