Lanove/HotBerry/(notices)

Notices in the files:
parts and their libraries:
Wurth_Connectors_WR-USB: Copyright: Würth Elektronik
SparkFun-PowerSymbols: Licensing: Creative Commons ShareAlike 4.0 International - https://creativecommons.org/licenses/by-sa/4.0
